koonie404/ros2-cobot-autonomous-navigation/assets/main-controller-schematic.png

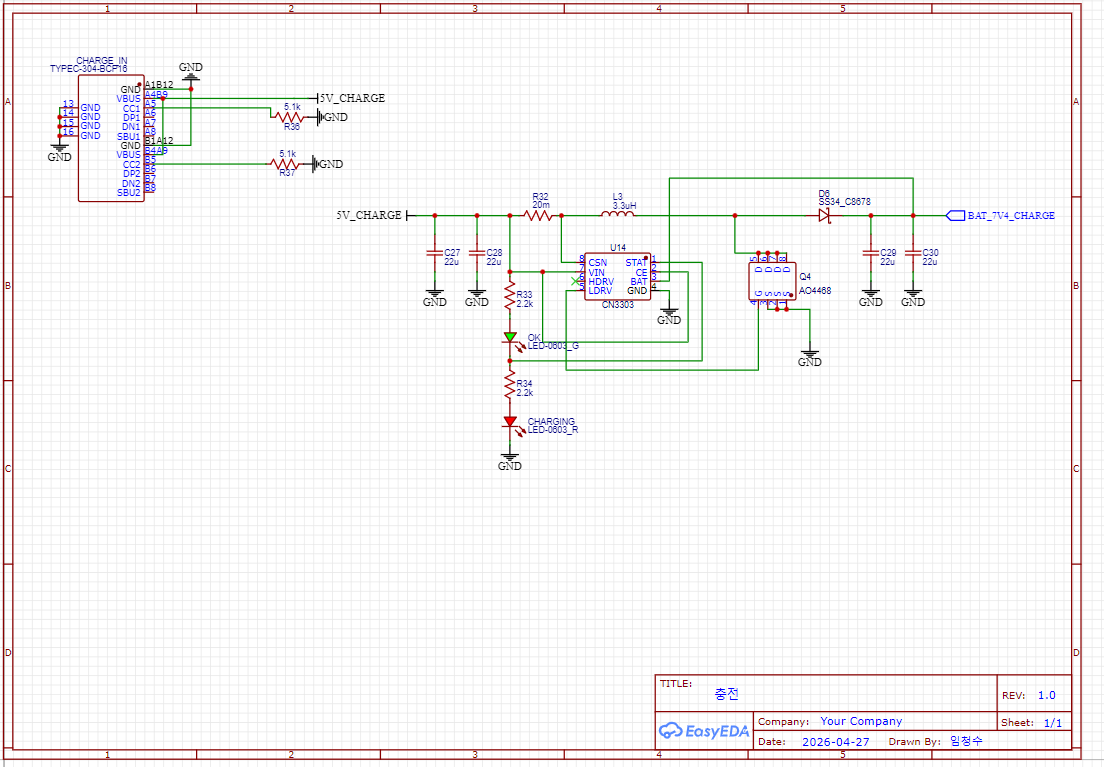
assets/main-controller-schematic.png
