koonie404/ros2-cobot-autonomous-navigation/ros2_ws/src/co_bot_2_description/meshes/slide_b3.stl

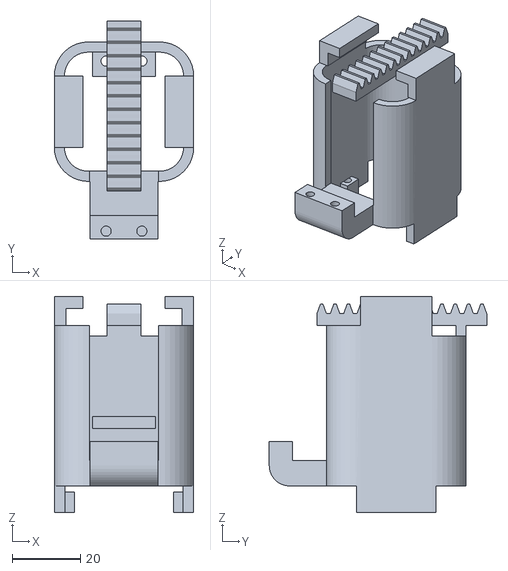
[picture p8: CAD file, 2026-06-22]
ros2_ws/src/co_bot_2_description/meshes/slide_b3.stl
41.0 x 64.0 x 63.5
