koonie404/ros2-cobot-autonomous-navigation/ros2_ws/src/co_bot_2_description/meshes/body_part11.stl

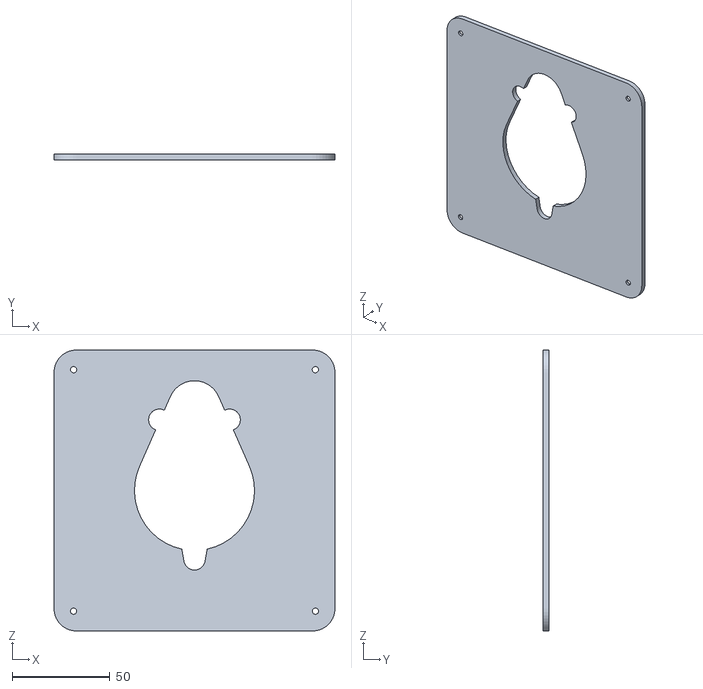
[picture p9: CAD file, 2026-06-22]
ros2_ws/src/co_bot_2_description/meshes/body_part11.stl
144.0 x 3.00 x 144.0
