koonie404/ros2-cobot-autonomous-navigation/ros2_ws/src/co_bot_2_description/meshes/left_wheel_part2.stl

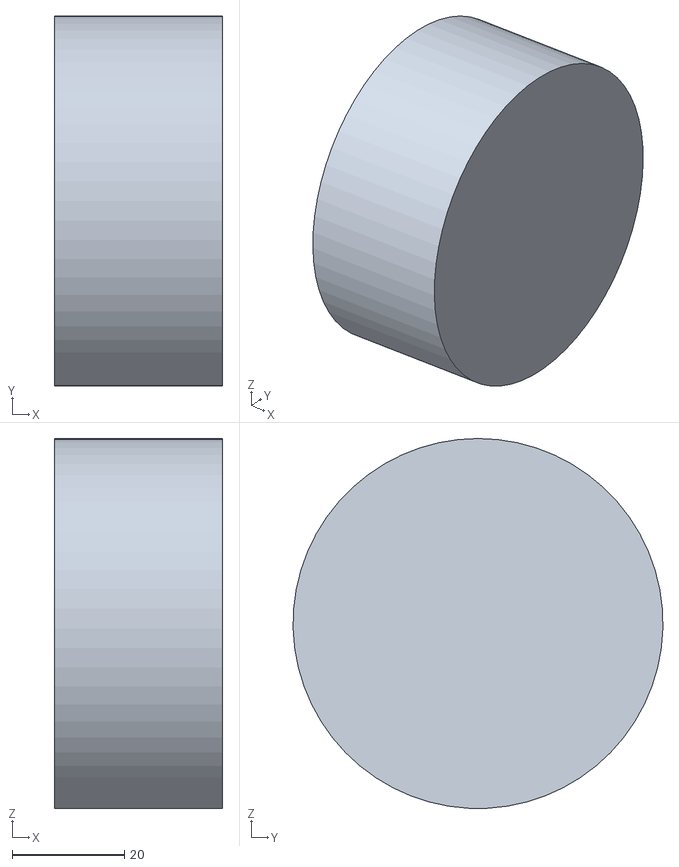
[picture p10: CAD file, 2026-06-22]
ros2_ws/src/co_bot_2_description/meshes/left_wheel_part2.stl
30.0 x 66.0 x 66.0
