koonie404/ros2-cobot-autonomous-navigation/ros2_ws/src/co_bot_2_description/meshes/body_part20_1.stl

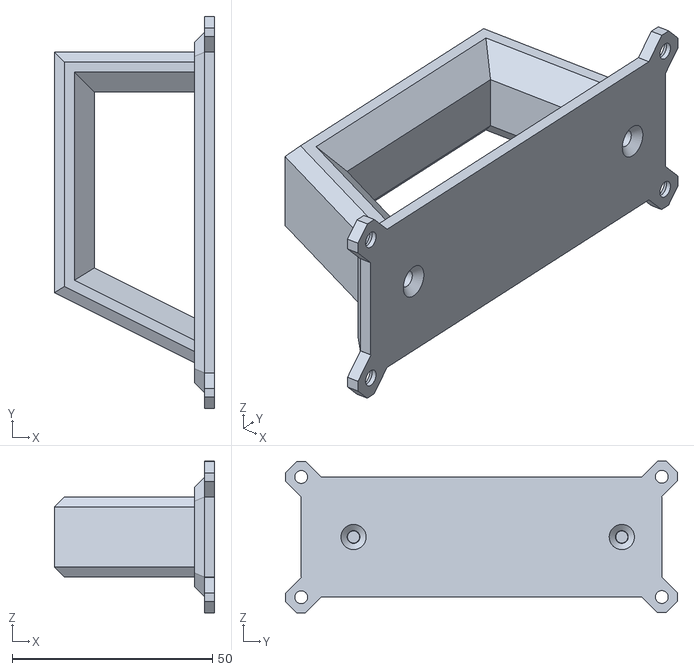
[picture p11: CAD file, 2026-06-22]
ros2_ws/src/co_bot_2_description/meshes/body_part20_1.stl
40.0 x 97.8 x 37.9
