koonie404/ros2-cobot-autonomous-navigation/ros2_ws/src/co_bot_2_description/meshes/body_lidar_part12.stl

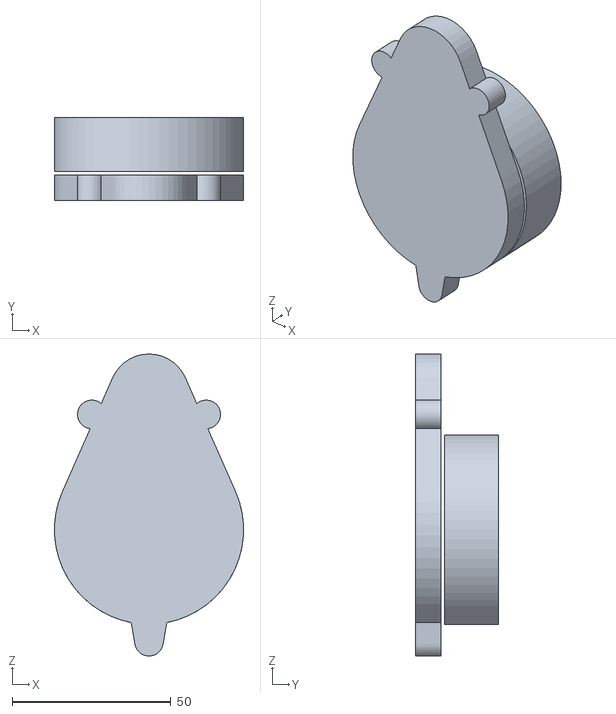
[picture p12: CAD file, 2026-06-22]
ros2_ws/src/co_bot_2_description/meshes/body_lidar_part12.stl
59.5 x 26.0 x 95.0
