koonie404/ros2-cobot-autonomous-navigation/ros2_ws/src/co_bot_2_description/meshes/body_part10.stl

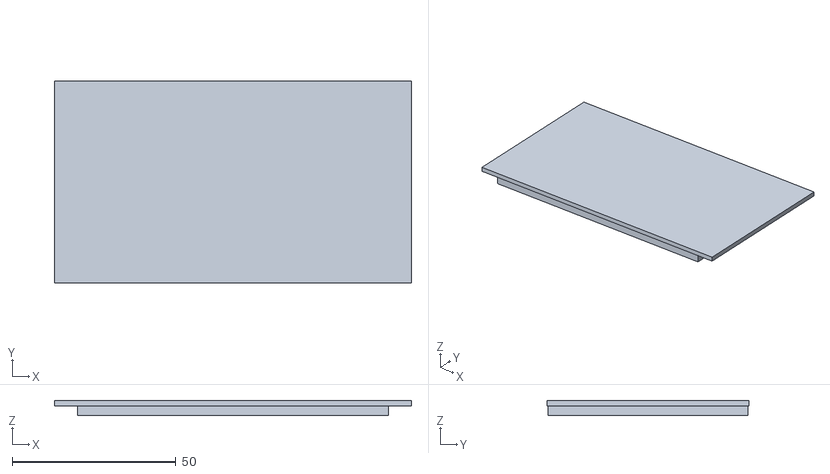
[picture p13: CAD file, 2026-06-22]
ros2_ws/src/co_bot_2_description/meshes/body_part10.stl
109.0 x 61.8 x 4.70
