koonie404/ros2-cobot-autonomous-navigation/ros2_ws/src/co_bot_2_description/meshes/left_gripper_part17.stl

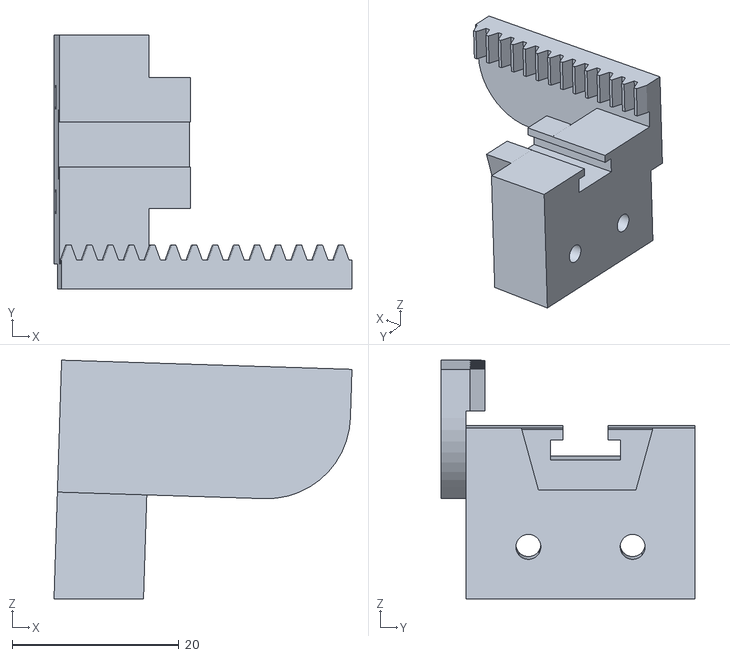
[picture p14: CAD file, 2026-06-22]
ros2_ws/src/co_bot_2_description/meshes/left_gripper_part17.stl
35.7 x 30.5 x 28.6
