koonie404/ros2-cobot-autonomous-navigation/ros2_ws/src/co_bot_2_description/meshes/body_part12_boss1.stl

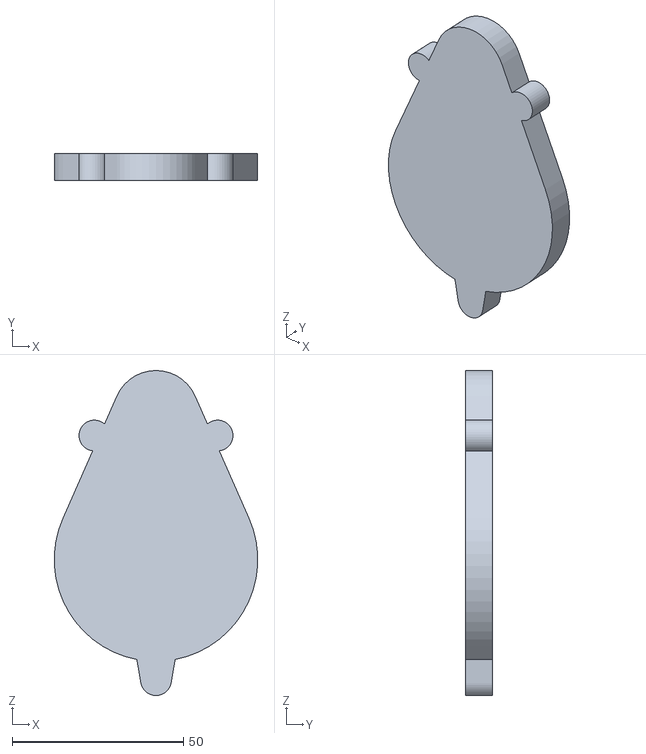
[picture p15: CAD file, 2026-06-22]
ros2_ws/src/co_bot_2_description/meshes/body_part12_boss1.stl
59.4 x 8.00 x 95.0
