koonie404/ros2-cobot-autonomous-navigation/ros2_ws/src/co_bot_2_description/meshes/body_part24_2.stl

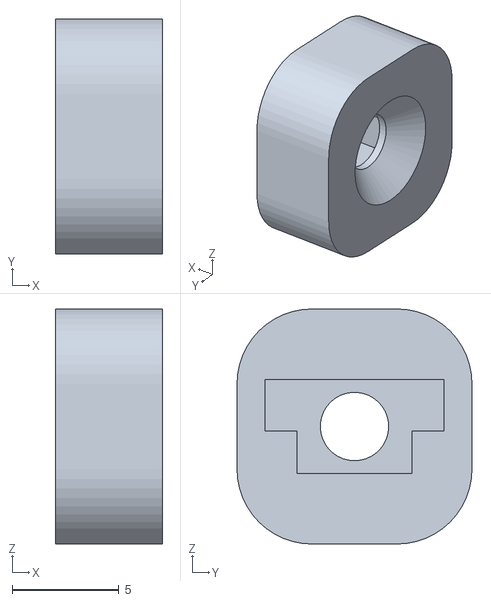
[picture p16: CAD file, 2026-06-22]
ros2_ws/src/co_bot_2_description/meshes/body_part24_2.stl
5.00 x 11.0 x 11.0
