koonie404/ros2-cobot-autonomous-navigation/ros2_ws/src/co_bot_2_description/meshes/camera_part9.stl

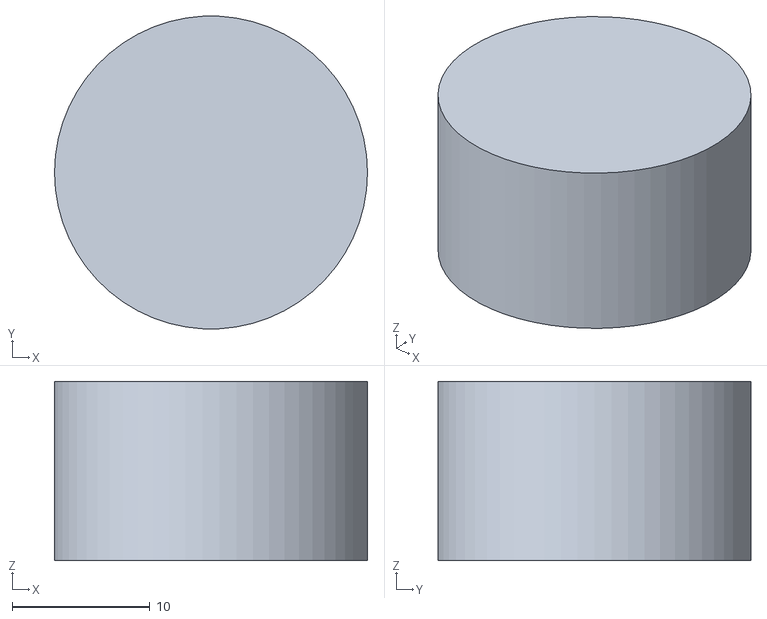
[picture p17: CAD file, 2026-06-22]
ros2_ws/src/co_bot_2_description/meshes/camera_part9.stl
22.7 x 22.7 x 13.0
