koonie404/ros2-cobot-autonomous-navigation/ros2_ws/src/co_bot_2_description/meshes/right_gripper_part17.stl

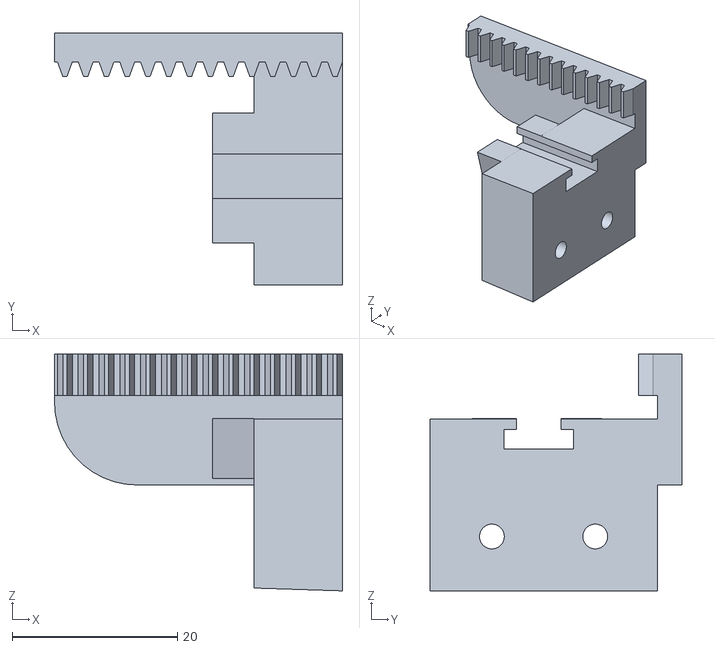
[picture p18: CAD file, 2026-06-22]
ros2_ws/src/co_bot_2_description/meshes/right_gripper_part17.stl
34.8 x 30.5 x 28.6
