koonie404/ros2-cobot-autonomous-navigation/ros2_ws/src/co_bot_2_description/meshes/lidar_part12_boss3.stl

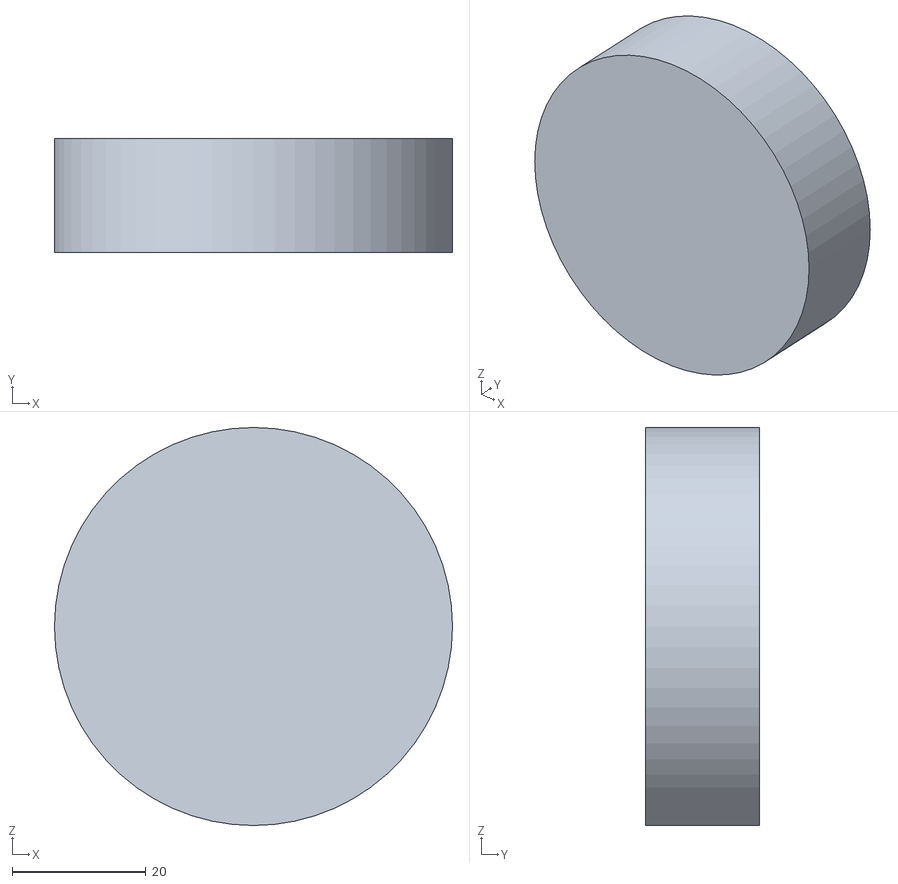
[picture p19: CAD file, 2026-06-22]
ros2_ws/src/co_bot_2_description/meshes/lidar_part12_boss3.stl
59.5 x 17.0 x 59.5
