koonie404/ros2-cobot-autonomous-navigation/ros2_ws/src/co_bot_2_description/meshes/body_part19.stl

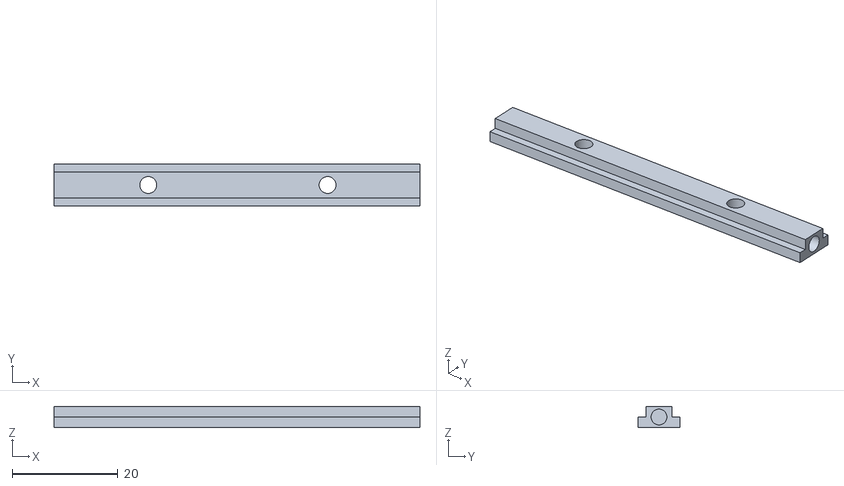
[picture p20: CAD file, 2026-06-22]
ros2_ws/src/co_bot_2_description/meshes/body_part19.stl
69.4 x 8.00 x 4.00
