koonie404/ros2-cobot-autonomous-navigation/ros2_ws/src/co_bot_2_description/meshes/right_hand_part22.stl

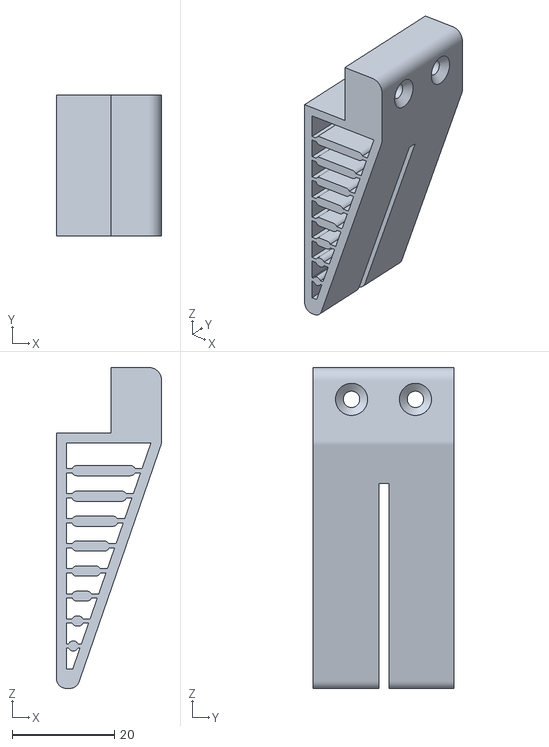
[picture p21: CAD file, 2026-06-22]
ros2_ws/src/co_bot_2_description/meshes/right_hand_part22.stl
20.6 x 27.5 x 62.8
