koonie404/ros2-cobot-autonomous-navigation/ros2_ws/src/co_bot_2_description/meshes/body_b1.stl

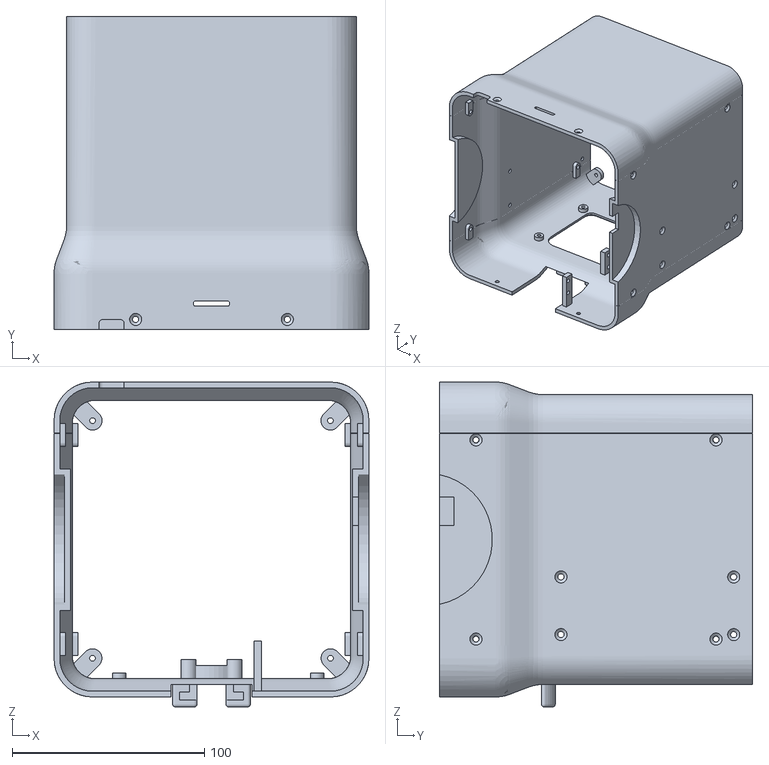
[picture p22: CAD file, 2026-06-22]
ros2_ws/src/co_bot_2_description/meshes/body_b1.stl
164.0 x 163.0 x 169.2
