koonie404/ros2-cobot-autonomous-navigation/ros2_ws/src/co_bot_2_description/meshes/body_b2.stl

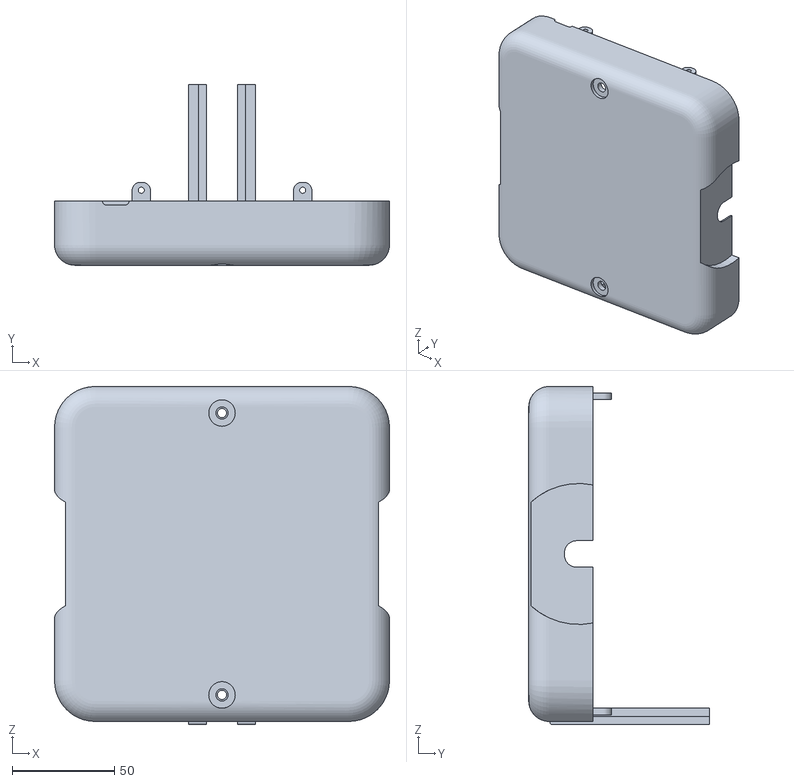
[picture p23: CAD file, 2026-06-22]
ros2_ws/src/co_bot_2_description/meshes/body_b2.stl
164.0 x 88.4 x 165.5
