koonie404/ros2-cobot-autonomous-navigation/(list of files, cad)

Other CAD files:
ros2_ws/src/co_bot_2_description/meshes/body_part20_2.stl
ros2_ws/src/co_bot_2_description/meshes/left_hand_part22.stl
ros2_ws/src/co_bot_2_description/meshes/right_wheel_part2.stl
ros2_ws/src/co_bot_2_description/meshes/body_spi_lcd.stl
ros2_ws/src/co_bot_2_description/meshes/body_part24_1.stl
